ashleyjr/fft8051/hardware/fft8051/fft8051.kicad_pcb

## KiCad design hardware/fft8051/fft8051.kicad_pcb (2020-05-10)

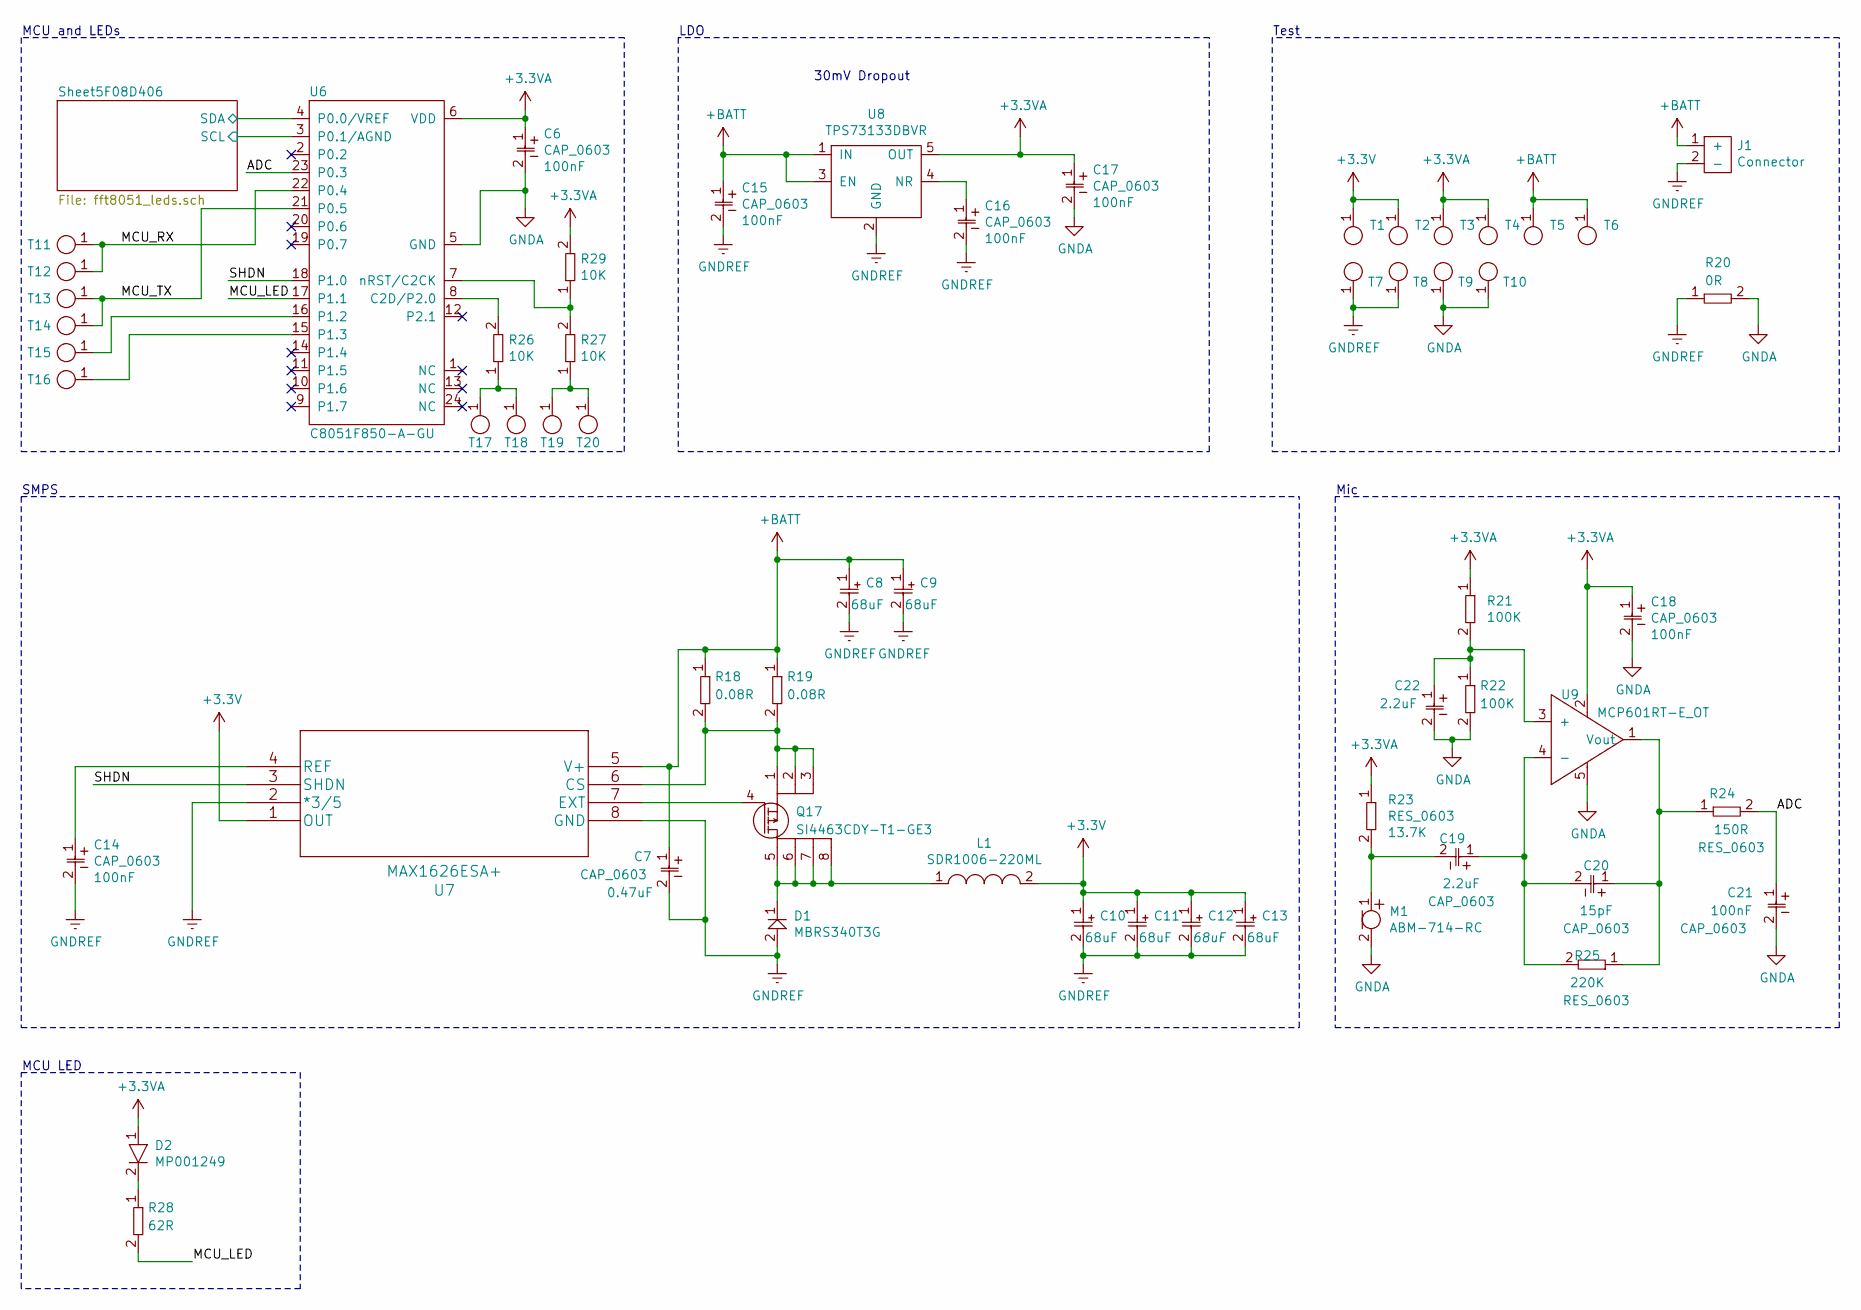
[picture p1: schematic fft8051.sch]

Parts:
C6, C7, C14, C15, C16, C17, C18, C19, C20, C21, C22: CAP_0603; 0603
C8, C9, C10, C11, C12, C13: T55B686M6R3C0070
D1: MBRS340T3G
D2: MP001249
J1: Connector
L1: SDR1006-220ML
M1: ABM-714-RC
Q17: SI4463CDY-T1-GE3
R18, R19, R20, R21, R22, R23, R24, R25, R26, R27, R28, R29: RES_0603; 0603
T1, T2, T3, T4, T5, T6, T7, T8, T9, T10, T11, T12, T13, T14, T15, T16, T17, T18, T19, T20: TestPoints; TestPoint
U6: C8051F850-A-GU
U7: MAX1626ESA+; MAX1626ESA&plus_
U8: TPS73133DBVR
U9: MCP601RT-E_OT; MCP601RT

Connections:
+3.3VA: C6.1, C17.1, C18.1, D2.1, R21.1, R23.1, R29.2, T3.1, T4.1, U6.6 (VDD), U8.5 (OUT), U9.2
+3V3: C10.1, C11.1, C12.1, C13.1, L1.2, T1.1, T2.1, U7.1 (OUT); also elsewhere on the board
+BATT: C7.1, C8.1, C9.1, C15.1, J1.1 (+), R18.1, R19.1, T5.1, T6.1, U7.5 (V+), U8.1 (IN), U8.3 (EN)
/ADC: C21.1, R24.2, U6.23 (P0.3)
/MCU_LED: R28.2, U6.17 (P1.1)
/MCU_RX: T11.1, T12.1, U6.22 (P0.4)
/MCU_TX: T13.1, T14.1, U6.21 (P0.5)
/SHDN: U6.18 (P1.0), U7.3 (SHDN)
/Sheet5F08D406/SCL: U6.3 (P0.1/AGND); also elsewhere on the board
/Sheet5F08D406/SDA: U6.4 (P0.0/VREF); also elsewhere on the board
GNDA: C6.2, C17.2, C18.2, C21.2, C22.2, M1.2, R20.2, R22.2, T9.1, T10.1, U6.5 (GND), U9.5
GNDREF: C7.2, C8.2, C9.2, C10.2, C11.2, C12.2, C13.2, C14.2, C15.2, C16.2, D1.2, J1.2 (-), R20.1, T7.1, T8.1, U7.2 (*3/5), U7.8 (GND), U8.2 (GND); also elsewhere on the board
unnamed: C14.1, U7.4 (REF)
unnamed: C16.1, U8.4 (NR)
unnamed: C19.1, C20.2, R25.2, U9.4 (-)
unnamed: C19.2, M1.1, R23.2
unnamed: C20.1, R24.1, R25.1, U9.1 (Vout)
unnamed: C22.1, R21.2, R22.1, U9.3 (+)
unnamed: D1.1, L1.1, Q17.5, Q17.6, Q17.7, Q17.8
unnamed: D2.2, R28.1
unnamed: Q17.1, Q17.2, Q17.3, R18.2, R19.2, U7.6 (CS)
unnamed: Q17.4, U7.7 (EXT)
unnamed: R26.1, T17.1, T18.1
unnamed: R26.2, U6.8 (C2D/P2.0)
unnamed: R27.1, T19.1, T20.1
unnamed: R27.2, R29.1, U6.7 (nRST/C2CK)
unnamed: T15.1, U6.16 (P1.2)
unnamed: T16.1, U6.15 (P1.3)

Notes on the sheet:
SMPS
MCU and LEDs
LDO
30mV Dropout
Test
Mic
MCU LED

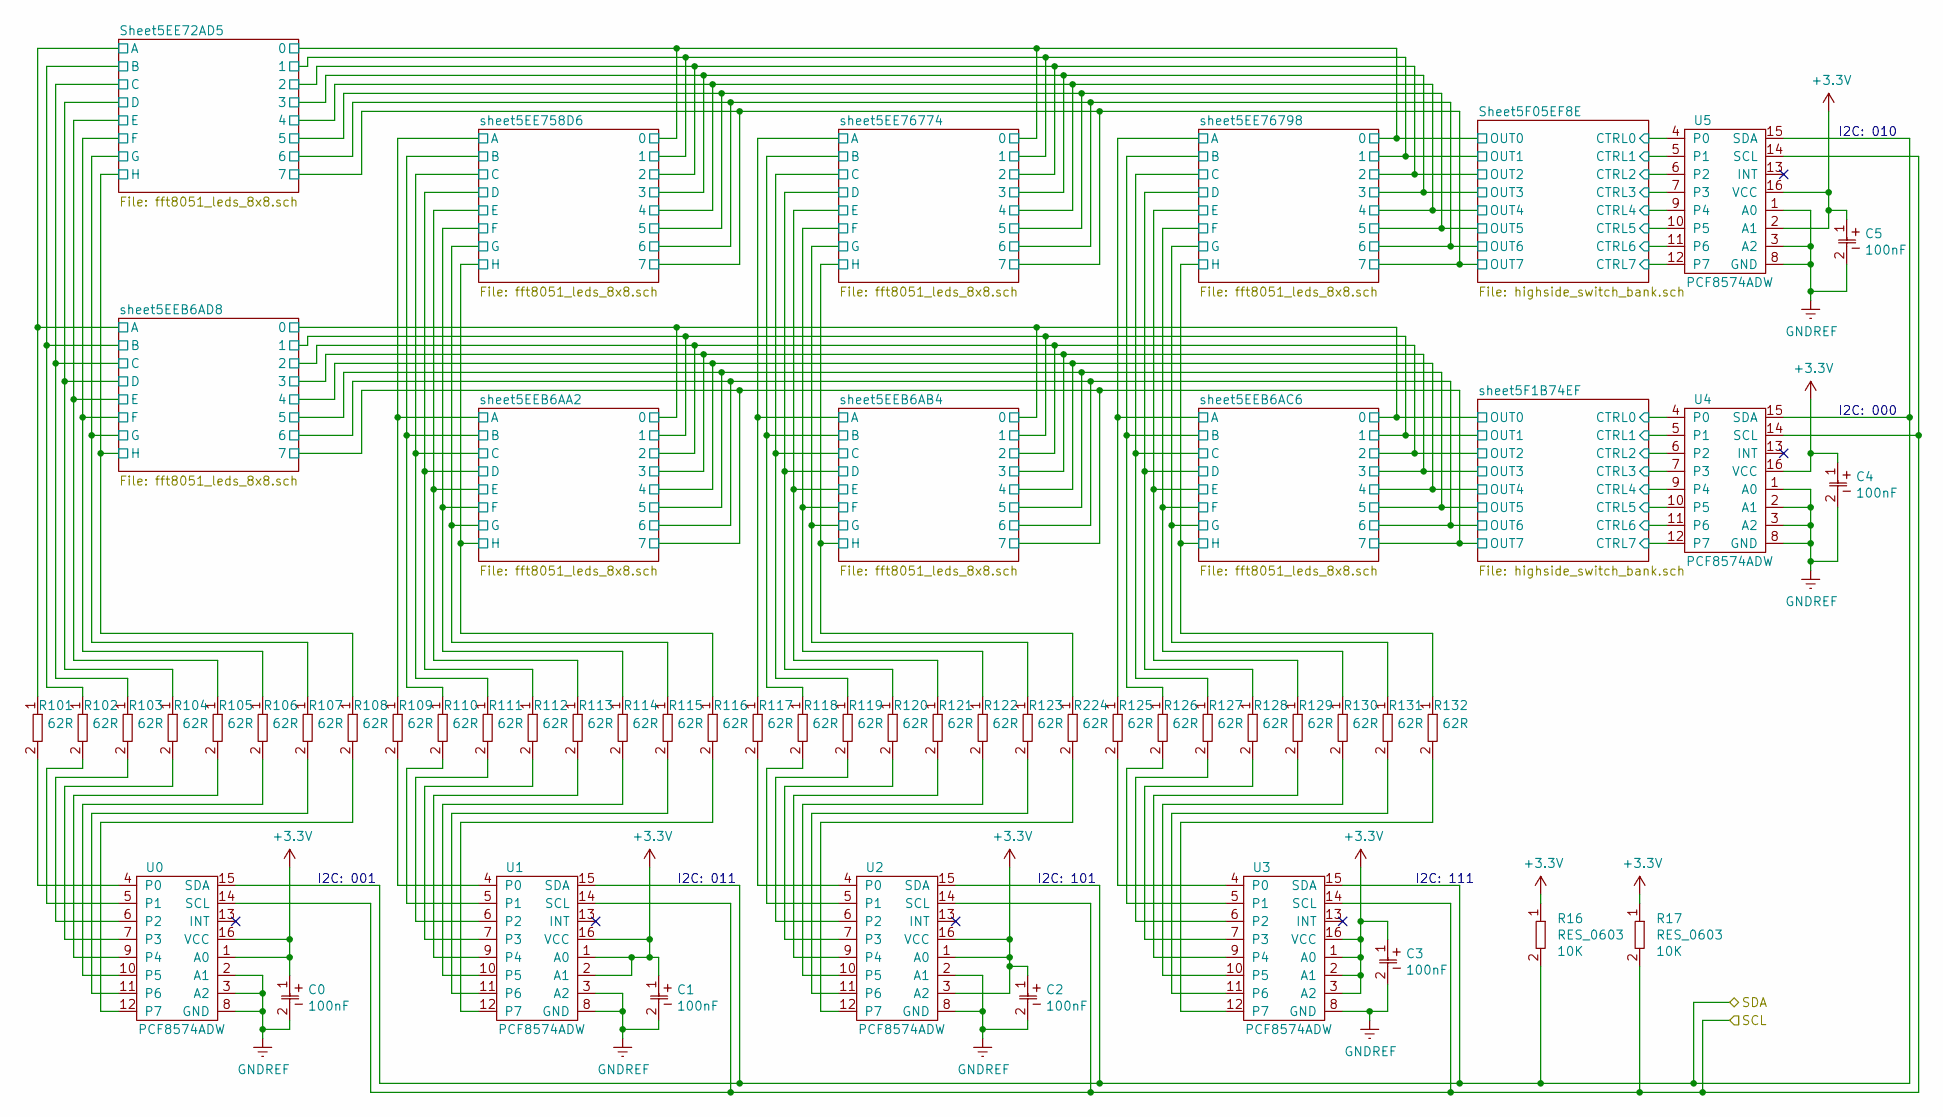
[picture p2: schematic fft8051_leds.sch]

Parts:
C0, C1, C2, C3, C4, C5: CAP_0603; 0603
R16, R17, R101, R102, R103, R104, R105, R106, R107, R108, R109, R110, R111, R112, R113, R114, R115, R116, R117, R118, R119, R120, R121, R122, R123, R125, R126, R127, R128, R129, R130, R131, R132, R224: RES_0603; 0603
U0, U1, U2, U3, U4, U5: PCF8574ADW

Connections:
+3V3: C0.1, C1.1, C2.1, C3.1, C4.1, C5.1, R16.1, R17.1, U0.1 (A0), U0.16 (VCC), U1.1 (A0), U1.2 (A1), U1.16 (VCC), U2.1 (A0), U2.3 (A2), U2.16 (VCC), U3.1 (A0), U3.2 (A1), U3.3 (A2), U3.16 (VCC), U4.16 (VCC), U5.2 (A1), U5.16 (VCC); also elsewhere on the board
/Sheet5F08D406/SCL: R17.2, U0.14 (SCL), U1.14 (SCL), U2.14 (SCL), U3.14 (SCL), U4.14 (SCL), U5.14 (SCL); also elsewhere on the board
/Sheet5F08D406/SDA: R16.2, U0.15 (SDA), U1.15 (SDA), U2.15 (SDA), U3.15 (SDA), U4.15 (SDA), U5.15 (SDA); also elsewhere on the board
/Sheet5F08D406/Sheet5EE72AD5/A: R101.1; also elsewhere on the board
/Sheet5F08D406/Sheet5EE72AD5/B: R102.1; also elsewhere on the board
/Sheet5F08D406/Sheet5EE72AD5/C: R103.1; also elsewhere on the board
/Sheet5F08D406/Sheet5EE72AD5/D: R104.1; also elsewhere on the board
/Sheet5F08D406/Sheet5EE72AD5/E: R105.1; also elsewhere on the board
/Sheet5F08D406/Sheet5EE72AD5/F: R106.1; also elsewhere on the board
/Sheet5F08D406/Sheet5EE72AD5/G: R107.1; also elsewhere on the board
/Sheet5F08D406/Sheet5EE72AD5/H: R108.1; also elsewhere on the board
/Sheet5F08D406/Sheet5F05EF8E/CTRL0: U5.4 (P0); also elsewhere on the board
/Sheet5F08D406/Sheet5F05EF8E/CTRL1: U5.5 (P1); also elsewhere on the board
/Sheet5F08D406/Sheet5F05EF8E/CTRL2: U5.6 (P2); also elsewhere on the board
/Sheet5F08D406/Sheet5F05EF8E/CTRL3: U5.7 (P3); also elsewhere on the board
/Sheet5F08D406/Sheet5F05EF8E/CTRL4: U5.9 (P4); also elsewhere on the board
/Sheet5F08D406/Sheet5F05EF8E/CTRL5: U5.10 (P5); also elsewhere on the board
/Sheet5F08D406/Sheet5F05EF8E/CTRL6: U5.11 (P6); also elsewhere on the board
/Sheet5F08D406/Sheet5F05EF8E/CTRL7: U5.12 (P7); also elsewhere on the board
/Sheet5F08D406/sheet5EE758D6/A: R109.1; also elsewhere on the board
/Sheet5F08D406/sheet5EE758D6/B: R110.1; also elsewhere on the board
/Sheet5F08D406/sheet5EE758D6/C: R111.1; also elsewhere on the board
/Sheet5F08D406/sheet5EE758D6/D: R112.1; also elsewhere on the board
/Sheet5F08D406/sheet5EE758D6/E: R113.1; also elsewhere on the board
/Sheet5F08D406/sheet5EE758D6/F: R114.1; also elsewhere on the board
/Sheet5F08D406/sheet5EE758D6/G: R115.1; also elsewhere on the board
/Sheet5F08D406/sheet5EE758D6/H: R116.1; also elsewhere on the board
/Sheet5F08D406/sheet5EE76774/A: R117.1; also elsewhere on the board
/Sheet5F08D406/sheet5EE76774/B: R118.1; also elsewhere on the board
/Sheet5F08D406/sheet5EE76774/C: R119.1; also elsewhere on the board
/Sheet5F08D406/sheet5EE76774/D: R120.1; also elsewhere on the board
/Sheet5F08D406/sheet5EE76774/E: R121.1; also elsewhere on the board
/Sheet5F08D406/sheet5EE76774/F: R122.1; also elsewhere on the board
/Sheet5F08D406/sheet5EE76774/G: R123.1; also elsewhere on the board
/Sheet5F08D406/sheet5EE76774/H: R224.1; also elsewhere on the board
/Sheet5F08D406/sheet5EE76798/A: R125.1; also elsewhere on the board
/Sheet5F08D406/sheet5EE76798/B: R126.1; also elsewhere on the board
/Sheet5F08D406/sheet5EE76798/C: R127.1; also elsewhere on the board
/Sheet5F08D406/sheet5EE76798/D: R128.1; also elsewhere on the board
/Sheet5F08D406/sheet5EE76798/E: R129.1; also elsewhere on the board
/Sheet5F08D406/sheet5EE76798/F: R130.1; also elsewhere on the board
/Sheet5F08D406/sheet5EE76798/G: R131.1; also elsewhere on the board
/Sheet5F08D406/sheet5EE76798/H: R132.1; also elsewhere on the board
/Sheet5F08D406/sheet5F1B74EF/CTRL0: U4.4 (P0); also elsewhere on the board
/Sheet5F08D406/sheet5F1B74EF/CTRL1: U4.5 (P1); also elsewhere on the board
/Sheet5F08D406/sheet5F1B74EF/CTRL2: U4.6 (P2); also elsewhere on the board
/Sheet5F08D406/sheet5F1B74EF/CTRL3: U4.7 (P3); also elsewhere on the board
/Sheet5F08D406/sheet5F1B74EF/CTRL4: U4.9 (P4); also elsewhere on the board
/Sheet5F08D406/sheet5F1B74EF/CTRL5: U4.10 (P5); also elsewhere on the board
/Sheet5F08D406/sheet5F1B74EF/CTRL6: U4.11 (P6); also elsewhere on the board
/Sheet5F08D406/sheet5F1B74EF/CTRL7: U4.12 (P7); also elsewhere on the board
GNDREF: C0.2, C1.2, C2.2, C3.2, C4.2, C5.2, U0.2 (A1), U0.3 (A2), U0.8 (GND), U1.3 (A2), U1.8 (GND), U2.2 (A1), U2.8 (GND), U3.8 (GND), U4.1 (A0), U4.2 (A1), U4.3 (A2), U4.8 (GND), U5.1 (A0), U5.3 (A2), U5.8 (GND); also elsewhere on the board
unnamed: R101.2, U0.4 (P0)
unnamed: R102.2, U0.5 (P1)
unnamed: R103.2, U0.6 (P2)
unnamed: R104.2, U0.7 (P3)
unnamed: R105.2, U0.9 (P4)
unnamed: R106.2, U0.10 (P5)
unnamed: R107.2, U0.11 (P6)
unnamed: R108.2, U0.12 (P7)
unnamed: R109.2, U1.4 (P0)
unnamed: R110.2, U1.5 (P1)
unnamed: R111.2, U1.6 (P2)
unnamed: R112.2, U1.7 (P3)
unnamed: R113.2, U1.9 (P4)
unnamed: R114.2, U1.10 (P5)
unnamed: R115.2, U1.11 (P6)
unnamed: R116.2, U1.12 (P7)
unnamed: R117.2, U2.4 (P0)
unnamed: R118.2, U2.5 (P1)
unnamed: R119.2, U2.6 (P2)
unnamed: R120.2, U2.7 (P3)
unnamed: R121.2, U2.9 (P4)
unnamed: R122.2, U2.10 (P5)
unnamed: R123.2, U2.11 (P6)
unnamed: R125.2, U3.4 (P0)
unnamed: R126.2, U3.5 (P1)
unnamed: R127.2, U3.6 (P2)
unnamed: R128.2, U3.7 (P3)
unnamed: R129.2, U3.9 (P4)
unnamed: R130.2, U3.10 (P5)
unnamed: R131.2, U3.11 (P6)
unnamed: R132.2, U3.12 (P7)
unnamed: R224.2, U2.12 (P7)

Notes on the sheet:
I2C: 111
I2C: 101
I2C: 011
I2C: 001
I2C: 000
I2C: 010

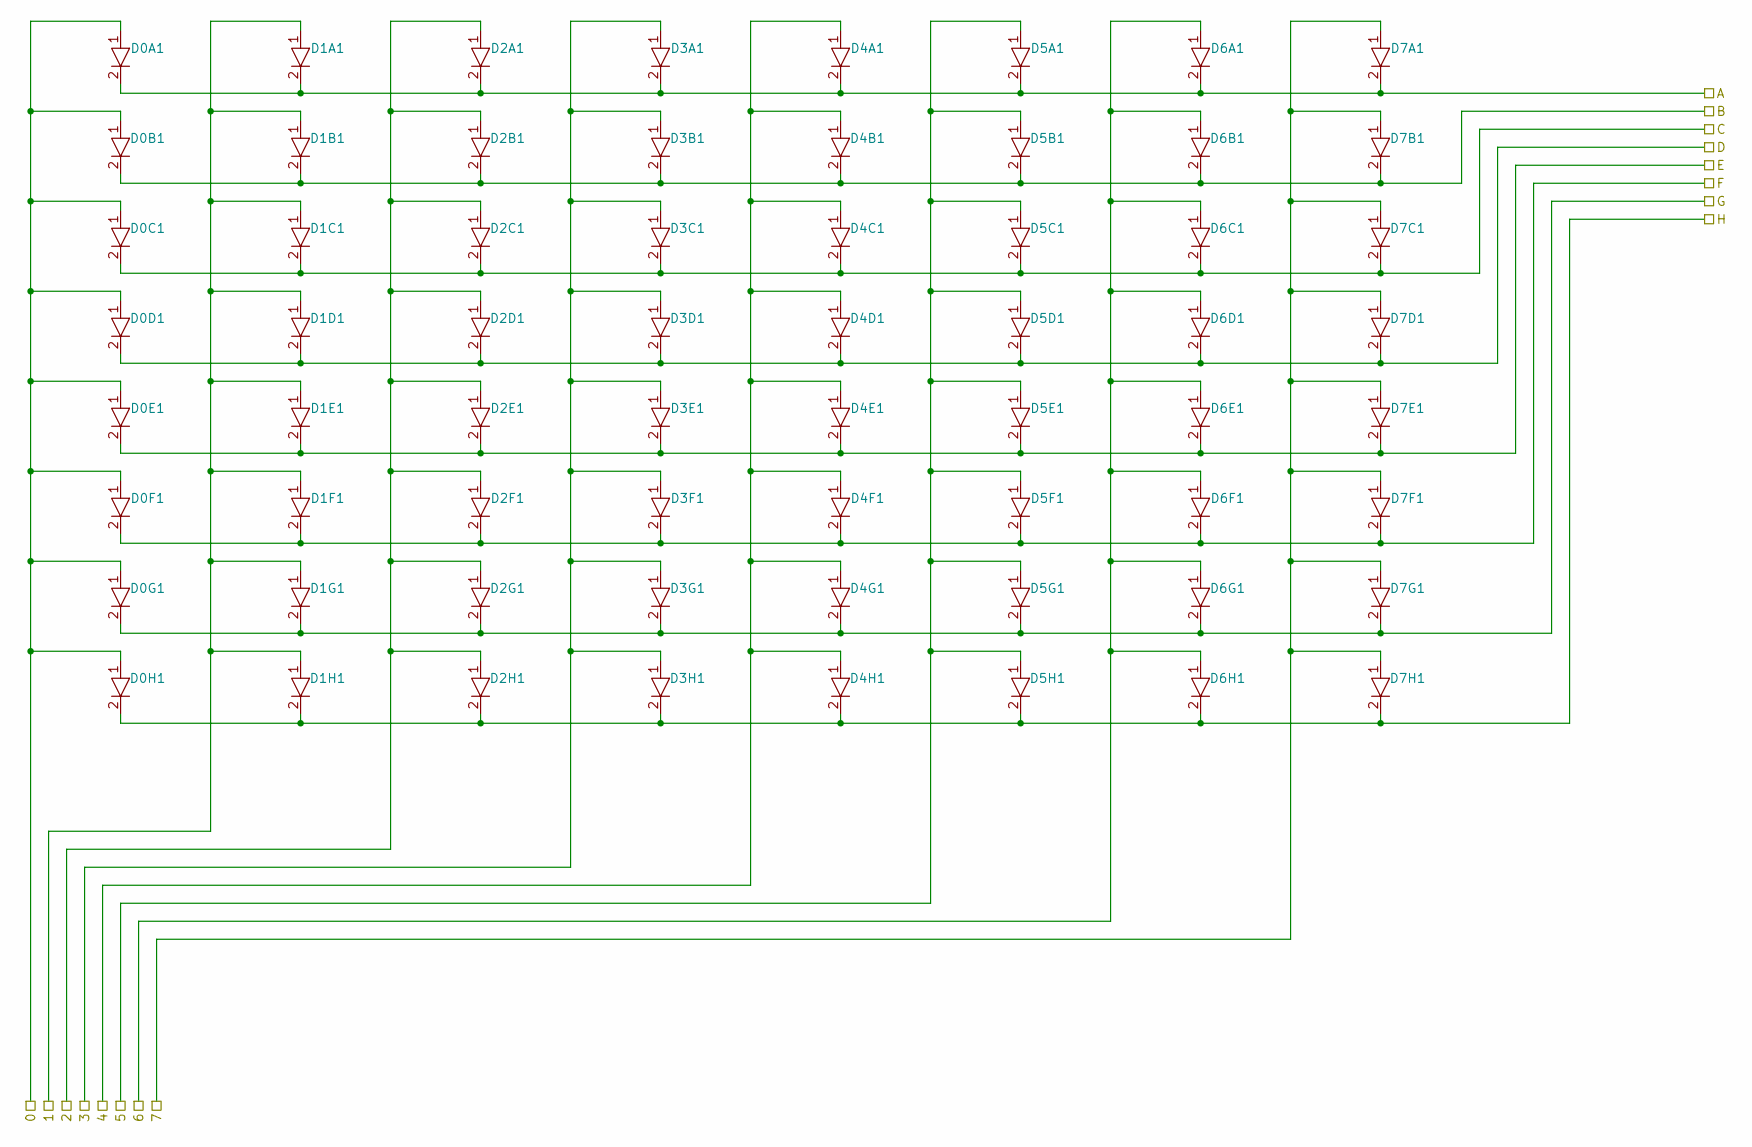
[picture p3: schematic fft8051_leds_8x8.sch]

Parts:
D0A1, D0B1, D0C1, D0D1, D0E1, D0F1, D0G1, D0H1, D1A1, D1B1, D1C1, D1D1, D1E1, D1F1, D1G1, D1H1, D2A1, D2B1, D2C1, D2D1, D2E1, D2F1, D2G1, D2H1, D3A1, D3B1, D3C1, D3D1, D3E1, D3F1, D3G1, D3H1, D4A1, D4B1, D4C1, D4D1, D4E1, D4F1, D4G1, D4H1, D5A1, D5B1, D5C1, D5D1, D5E1, D5F1, D5G1, D5H1, D6A1, D6B1, D6C1, D6D1, D6E1, D6F1, D6G1, D6H1, D7A1, D7B1, D7C1, D7D1, D7E1, D7F1, D7G1, D7H1: MP001249

Connections:
/Sheet5F08D406/Sheet5EE72AD5/0: D0A1.1, D0B1.1, D0C1.1, D0D1.1, D0E1.1, D0F1.1, D0G1.1, D0H1.1; also elsewhere on the board
/Sheet5F08D406/Sheet5EE72AD5/1: D1A1.1, D1B1.1, D1C1.1, D1D1.1, D1E1.1, D1F1.1, D1G1.1, D1H1.1; also elsewhere on the board
/Sheet5F08D406/Sheet5EE72AD5/2: D2A1.1, D2B1.1, D2C1.1, D2D1.1, D2E1.1, D2F1.1, D2G1.1, D2H1.1; also elsewhere on the board
/Sheet5F08D406/Sheet5EE72AD5/3: D3A1.1, D3B1.1, D3C1.1, D3D1.1, D3E1.1, D3F1.1, D3G1.1, D3H1.1; also elsewhere on the board
/Sheet5F08D406/Sheet5EE72AD5/4: D4A1.1, D4B1.1, D4C1.1, D4D1.1, D4E1.1, D4F1.1, D4G1.1, D4H1.1; also elsewhere on the board
/Sheet5F08D406/Sheet5EE72AD5/5: D5A1.1, D5B1.1, D5C1.1, D5D1.1, D5E1.1, D5F1.1, D5G1.1, D5H1.1; also elsewhere on the board
/Sheet5F08D406/Sheet5EE72AD5/6: D6A1.1, D6B1.1, D6C1.1, D6D1.1, D6E1.1, D6F1.1, D6G1.1, D6H1.1; also elsewhere on the board
/Sheet5F08D406/Sheet5EE72AD5/7: D7A1.1, D7B1.1, D7C1.1, D7D1.1, D7E1.1, D7F1.1, D7G1.1, D7H1.1; also elsewhere on the board
/Sheet5F08D406/sheet5EE758D6/A: D0A1.2, D1A1.2, D2A1.2, D3A1.2, D4A1.2, D5A1.2, D6A1.2, D7A1.2; also elsewhere on the board
/Sheet5F08D406/sheet5EE758D6/B: D0B1.2, D1B1.2, D2B1.2, D3B1.2, D4B1.2, D5B1.2, D6B1.2, D7B1.2; also elsewhere on the board
/Sheet5F08D406/sheet5EE758D6/C: D0C1.2, D1C1.2, D2C1.2, D3C1.2, D4C1.2, D5C1.2, D6C1.2, D7C1.2; also elsewhere on the board
/Sheet5F08D406/sheet5EE758D6/D: D0D1.2, D1D1.2, D2D1.2, D3D1.2, D4D1.2, D5D1.2, D6D1.2, D7D1.2; also elsewhere on the board
/Sheet5F08D406/sheet5EE758D6/E: D0E1.2, D1E1.2, D2E1.2, D3E1.2, D4E1.2, D5E1.2, D6E1.2, D7E1.2; also elsewhere on the board
/Sheet5F08D406/sheet5EE758D6/F: D0F1.2, D1F1.2, D2F1.2, D3F1.2, D4F1.2, D5F1.2, D6F1.2, D7F1.2; also elsewhere on the board
/Sheet5F08D406/sheet5EE758D6/G: D0G1.2, D1G1.2, D2G1.2, D3G1.2, D4G1.2, D5G1.2, D6G1.2, D7G1.2; also elsewhere on the board
/Sheet5F08D406/sheet5EE758D6/H: D0H1.2, D1H1.2, D2H1.2, D3H1.2, D4H1.2, D5H1.2, D6H1.2, D7H1.2; also elsewhere on the board

Parts of its further copies:
D0A2, D0A3, D0A4, D0A5, D0A6, D0A7, D0A8, D0B2, D0B3, D0B4, D0B5, D0B6, D0B7, D0B8, D0C2, D0C3, D0C4, D0C5, D0C6, D0C7, D0C8, D0D2, D0D3, D0D4, D0D5, D0D6, D0D7, D0D8, D0E2, D0E3, D0E4, D0E5, D0E6, D0E7, D0E8, D0F2, D0F3, D0F4, D0F5, D0F6, D0F7, D0F8, D0G2, D0G3, D0G4, D0G5, D0G6, D0G7, D0G8, D0H2, D0H3, D0H4, D0H5, D0H6, D0H7, D0H8, D1A2, D1A3, D1A4, D1A5, D1A6, D1A7, D1A8, D1B2, D1B3, D1B4, D1B5, D1B6, D1B7, D1B8, D1C2, D1C3, D1C4, D1C5, D1C6, D1C7, D1C8, D1D2, D1D3, D1D4, D1D5, D1D6, D1D7, D1D8, D1E2, D1E3, D1E4, D1E5, D1E6, D1E7, D1E8, D1F2, D1F3, D1F4, D1F5, D1F6, D1F7, D1F8, D1G2, D1G3, D1G4, D1G5, D1G6, D1G7, D1G8, D1H2, D1H3, D1H4, D1H5, D1H6, D1H7, D1H8, D2A2, D2A3, D2A4, D2A5, D2A6, D2A7, D2A8, D2B2, D2B3, D2B4, D2B5, D2B6, D2B7, D2B8, D2C2, D2C3, D2C4, D2C5, D2C6, D2C7, D2C8, D2D2, D2D3, D2D4, D2D5, D2D6, D2D7, D2D8, D2E2, D2E3, D2E4, D2E5, D2E6, D2E7, D2E8, D2F2, D2F3, D2F4, D2F5, D2F6, D2F7, D2F8, D2G2, D2G3, D2G4, D2G5, D2G6, D2G7, D2G8, D2H2, D2H3, D2H4, D2H5, D2H6, D2H7, D2H8, D3A2, D3A3, D3A4, D3A5, D3A6, D3A7, D3A8, D3B2, D3B3, D3B4, D3B5, D3B6, D3B7, D3B8, D3C2, D3C3, D3C4, D3C5, D3C6, D3C7, D3C8, D3D2, D3D3, D3D4, D3D5, D3D6, D3D7, D3D8, D3E2, D3E3, D3E4, D3E5, D3E6, D3E7, D3E8, D3F2, D3F3, D3F4, D3F5, D3F6, D3F7, D3F8, D3G2, D3G3, D3G4, D3G5, D3G6, D3G7, D3G8, D3H2, D3H3, D3H4, D3H5, D3H6, D3H7, D3H8, D4A2, D4A3, D4A4, D4A5, D4A6, D4A7, D4A8, D4B2, D4B3, D4B4, D4B5, D4B6, D4B7, D4B8, D4C2, D4C3, D4C4, D4C5, D4C6, D4C7, D4C8, D4D2, D4D3, D4D4, D4D5, D4D6, D4D7, D4D8, D4E2, D4E3, D4E4, D4E5, D4E6, D4E7, D4E8, D4F2, D4F3, D4F4, D4F5, D4F6, D4F7, D4F8, D4G2, D4G3, D4G4, D4G5, D4G6, D4G7, D4G8, D4H2, D4H3, D4H4, D4H5, D4H6, D4H7, D4H8, D5A2, D5A3, D5A4, D5A5, D5A6, D5A7, D5A8, D5B2, D5B3, D5B4, D5B5, D5B6, D5B7, D5B8, D5C2, D5C3, D5C4, D5C5, D5C6, D5C7, D5C8, D5D2, D5D3, D5D4, D5D5, D5D6, D5D7, D5D8, D5E2, D5E3, D5E4, D5E5, D5E6, D5E7, D5E8, D5F2, D5F3, D5F4, D5F5, D5F6, D5F7, D5F8, D5G2, D5G3, D5G4, D5G5, D5G6, D5G7, D5G8, D5H2, D5H3, D5H4, D5H5, D5H6, D5H7, D5H8, D6A2, D6A3, D6A4, D6A5, D6A6, D6A7, D6A8, D6B2, D6B3, D6B4, D6B5, D6B6, D6B7, D6B8, D6C2, D6C3, D6C4, D6C5, D6C6, D6C7, D6C8, D6D2, D6D3, D6D4, D6D5, D6D6, D6D7, D6D8, D6E2, D6E3, D6E4, D6E5, D6E6, D6E7, D6E8, D6F2, D6F3, D6F4, D6F5, D6F6, D6F7, D6F8, D6G2, D6G3, D6G4, D6G5, D6G6, D6G7, D6G8, D6H2, D6H3, D6H4, D6H5, D6H6, D6H7, D6H8, D7A2, D7A3, D7A4, D7A5, D7A6, D7A7, D7A8, D7B2, D7B3, D7B4, D7B5, D7B6, D7B7, D7B8, D7C2, D7C3, D7C4, D7C5, D7C6, D7C7, D7C8, D7D2, D7D3, D7D4, D7D5, D7D6, D7D7, D7D8, D7E2, D7E3, D7E4, D7E5, D7E6, D7E7, D7E8, D7F2, D7F3, D7F4, D7F5, D7F6, D7F7, D7F8, D7G2, D7G3, D7G4, D7G5, D7G6, D7G7, D7G8, D7H2, D7H3, D7H4, D7H5, D7H6, D7H7, D7H8: MP001249

Connections of its further copies:
/Sheet5F08D406/Sheet5EE72AD5/0: D0A2.1, D0A3.1, D0A4.1, D0B2.1, D0B3.1, D0B4.1, D0C2.1, D0C3.1, D0C4.1, D0D2.1, D0D3.1, D0D4.1, D0E2.1, D0E3.1, D0E4.1, D0F2.1, D0F3.1, D0F4.1, D0G2.1, D0G3.1, D0G4.1, D0H2.1, D0H3.1, D0H4.1; also elsewhere on the board
/Sheet5F08D406/Sheet5EE72AD5/1: D1A2.1, D1A3.1, D1A4.1, D1B2.1, D1B3.1, D1B4.1, D1C2.1, D1C3.1, D1C4.1, D1D2.1, D1D3.1, D1D4.1, D1E2.1, D1E3.1, D1E4.1, D1F2.1, D1F3.1, D1F4.1, D1G2.1, D1G3.1, D1G4.1, D1H2.1, D1H3.1, D1H4.1; also elsewhere on the board
/Sheet5F08D406/Sheet5EE72AD5/2: D2A2.1, D2A3.1, D2A4.1, D2B2.1, D2B3.1, D2B4.1, D2C2.1, D2C3.1, D2C4.1, D2D2.1, D2D3.1, D2D4.1, D2E2.1, D2E3.1, D2E4.1, D2F2.1, D2F3.1, D2F4.1, D2G2.1, D2G3.1, D2G4.1, D2H2.1, D2H3.1, D2H4.1; also elsewhere on the board
/Sheet5F08D406/Sheet5EE72AD5/3: D3A2.1, D3A3.1, D3A4.1, D3B2.1, D3B3.1, D3B4.1, D3C2.1, D3C3.1, D3C4.1, D3D2.1, D3D3.1, D3D4.1, D3E2.1, D3E3.1, D3E4.1, D3F2.1, D3F3.1, D3F4.1, D3G2.1, D3G3.1, D3G4.1, D3H2.1, D3H3.1, D3H4.1; also elsewhere on the board
/Sheet5F08D406/Sheet5EE72AD5/4: D4A2.1, D4A3.1, D4A4.1, D4B2.1, D4B3.1, D4B4.1, D4C2.1, D4C3.1, D4C4.1, D4D2.1, D4D3.1, D4D4.1, D4E2.1, D4E3.1, D4E4.1, D4F2.1, D4F3.1, D4F4.1, D4G2.1, D4G3.1, D4G4.1, D4H2.1, D4H3.1, D4H4.1; also elsewhere on the board
/Sheet5F08D406/Sheet5EE72AD5/5: D5A2.1, D5A3.1, D5A4.1, D5B2.1, D5B3.1, D5B4.1, D5C2.1, D5C3.1, D5C4.1, D5D2.1, D5D3.1, D5D4.1, D5E2.1, D5E3.1, D5E4.1, D5F2.1, D5F3.1, D5F4.1, D5G2.1, D5G3.1, D5G4.1, D5H2.1, D5H3.1, D5H4.1; also elsewhere on the board
/Sheet5F08D406/Sheet5EE72AD5/6: D6A2.1, D6A3.1, D6A4.1, D6B2.1, D6B3.1, D6B4.1, D6C2.1, D6C3.1, D6C4.1, D6D2.1, D6D3.1, D6D4.1, D6E2.1, D6E3.1, D6E4.1, D6F2.1, D6F3.1, D6F4.1, D6G2.1, D6G3.1, D6G4.1, D6H2.1, D6H3.1, D6H4.1; also elsewhere on the board
/Sheet5F08D406/Sheet5EE72AD5/7: D7A2.1, D7A3.1, D7A4.1, D7B2.1, D7B3.1, D7B4.1, D7C2.1, D7C3.1, D7C4.1, D7D2.1, D7D3.1, D7D4.1, D7E2.1, D7E3.1, D7E4.1, D7F2.1, D7F3.1, D7F4.1, D7G2.1, D7G3.1, D7G4.1, D7H2.1, D7H3.1, D7H4.1; also elsewhere on the board
/Sheet5F08D406/Sheet5EE72AD5/A: D0A4.2, D0A8.2, D1A4.2, D1A8.2, D2A4.2, D2A8.2, D3A4.2, D3A8.2, D4A4.2, D4A8.2, D5A4.2, D5A8.2, D6A4.2, D6A8.2, D7A4.2, D7A8.2; also elsewhere on the board
/Sheet5F08D406/Sheet5EE72AD5/B: D0B4.2, D0B8.2, D1B4.2, D1B8.2, D2B4.2, D2B8.2, D3B4.2, D3B8.2, D4B4.2, D4B8.2, D5B4.2, D5B8.2, D6B4.2, D6B8.2, D7B4.2, D7B8.2; also elsewhere on the board
/Sheet5F08D406/Sheet5EE72AD5/C: D0C4.2, D0C8.2, D1C4.2, D1C8.2, D2C4.2, D2C8.2, D3C4.2, D3C8.2, D4C4.2, D4C8.2, D5C4.2, D5C8.2, D6C4.2, D6C8.2, D7C4.2, D7C8.2; also elsewhere on the board
/Sheet5F08D406/Sheet5EE72AD5/D: D0D4.2, D0D8.2, D1D4.2, D1D8.2, D2D4.2, D2D8.2, D3D4.2, D3D8.2, D4D4.2, D4D8.2, D5D4.2, D5D8.2, D6D4.2, D6D8.2, D7D4.2, D7D8.2; also elsewhere on the board
/Sheet5F08D406/Sheet5EE72AD5/E: D0E4.2, D0E8.2, D1E4.2, D1E8.2, D2E4.2, D2E8.2, D3E4.2, D3E8.2, D4E4.2, D4E8.2, D5E4.2, D5E8.2, D6E4.2, D6E8.2, D7E4.2, D7E8.2; also elsewhere on the board
/Sheet5F08D406/Sheet5EE72AD5/F: D0F4.2, D0F8.2, D1F4.2, D1F8.2, D2F4.2, D2F8.2, D3F4.2, D3F8.2, D4F4.2, D4F8.2, D5F4.2, D5F8.2, D6F4.2, D6F8.2, D7F4.2, D7F8.2; also elsewhere on the board
/Sheet5F08D406/Sheet5EE72AD5/G: D0G4.2, D0G8.2, D1G4.2, D1G8.2, D2G4.2, D2G8.2, D3G4.2, D3G8.2, D4G4.2, D4G8.2, D5G4.2, D5G8.2, D6G4.2, D6G8.2, D7G4.2, D7G8.2; also elsewhere on the board
/Sheet5F08D406/Sheet5EE72AD5/H: D0H4.2, D0H8.2, D1H4.2, D1H8.2, D2H4.2, D2H8.2, D3H4.2, D3H8.2, D4H4.2, D4H8.2, D5H4.2, D5H8.2, D6H4.2, D6H8.2, D7H4.2, D7H8.2; also elsewhere on the board
/Sheet5F08D406/sheet5EE758D6/A: D0A5.2, D1A5.2, D2A5.2, D3A5.2, D4A5.2, D5A5.2, D6A5.2, D7A5.2; also elsewhere on the board
/Sheet5F08D406/sheet5EE758D6/B: D0B5.2, D1B5.2, D2B5.2, D3B5.2, D4B5.2, D5B5.2, D6B5.2, D7B5.2; also elsewhere on the board
/Sheet5F08D406/sheet5EE758D6/C: D0C5.2, D1C5.2, D2C5.2, D3C5.2, D4C5.2, D5C5.2, D6C5.2, D7C5.2; also elsewhere on the board
/Sheet5F08D406/sheet5EE758D6/D: D0D5.2, D1D5.2, D2D5.2, D3D5.2, D4D5.2, D5D5.2, D6D5.2, D7D5.2; also elsewhere on the board
/Sheet5F08D406/sheet5EE758D6/E: D0E5.2, D1E5.2, D2E5.2, D3E5.2, D4E5.2, D5E5.2, D6E5.2, D7E5.2; also elsewhere on the board
/Sheet5F08D406/sheet5EE758D6/F: D0F5.2, D1F5.2, D2F5.2, D3F5.2, D4F5.2, D5F5.2, D6F5.2, D7F5.2; also elsewhere on the board
/Sheet5F08D406/sheet5EE758D6/G: D0G5.2, D1G5.2, D2G5.2, D3G5.2, D4G5.2, D5G5.2, D6G5.2, D7G5.2; also elsewhere on the board
/Sheet5F08D406/sheet5EE758D6/H: D0H5.2, D1H5.2, D2H5.2, D3H5.2, D4H5.2, D5H5.2, D6H5.2, D7H5.2; also elsewhere on the board
/Sheet5F08D406/sheet5EE76774/A: D0A2.2, D0A6.2, D1A2.2, D1A6.2, D2A2.2, D2A6.2, D3A2.2, D3A6.2, D4A2.2, D4A6.2, D5A2.2, D5A6.2, D6A2.2, D6A6.2, D7A2.2, D7A6.2; also elsewhere on the board
/Sheet5F08D406/sheet5EE76774/B: D0B2.2, D0B6.2, D1B2.2, D1B6.2, D2B2.2, D2B6.2, D3B2.2, D3B6.2, D4B2.2, D4B6.2, D5B2.2, D5B6.2, D6B2.2, D6B6.2, D7B2.2, D7B6.2; also elsewhere on the board
/Sheet5F08D406/sheet5EE76774/C: D0C2.2, D0C6.2, D1C2.2, D1C6.2, D2C2.2, D2C6.2, D3C2.2, D3C6.2, D4C2.2, D4C6.2, D5C2.2, D5C6.2, D6C2.2, D6C6.2, D7C2.2, D7C6.2; also elsewhere on the board
/Sheet5F08D406/sheet5EE76774/D: D0D2.2, D0D6.2, D1D2.2, D1D6.2, D2D2.2, D2D6.2, D3D2.2, D3D6.2, D4D2.2, D4D6.2, D5D2.2, D5D6.2, D6D2.2, D6D6.2, D7D2.2, D7D6.2; also elsewhere on the board
/Sheet5F08D406/sheet5EE76774/E: D0E2.2, D0E6.2, D1E2.2, D1E6.2, D2E2.2, D2E6.2, D3E2.2, D3E6.2, D4E2.2, D4E6.2, D5E2.2, D5E6.2, D6E2.2, D6E6.2, D7E2.2, D7E6.2; also elsewhere on the board
/Sheet5F08D406/sheet5EE76774/F: D0F2.2, D0F6.2, D1F2.2, D1F6.2, D2F2.2, D2F6.2, D3F2.2, D3F6.2, D4F2.2, D4F6.2, D5F2.2, D5F6.2, D6F2.2, D6F6.2, D7F2.2, D7F6.2; also elsewhere on the board
/Sheet5F08D406/sheet5EE76774/G: D0G2.2, D0G6.2, D1G2.2, D1G6.2, D2G2.2, D2G6.2, D3G2.2, D3G6.2, D4G2.2, D4G6.2, D5G2.2, D5G6.2, D6G2.2, D6G6.2, D7G2.2, D7G6.2; also elsewhere on the board
/Sheet5F08D406/sheet5EE76774/H: D0H2.2, D0H6.2, D1H2.2, D1H6.2, D2H2.2, D2H6.2, D3H2.2, D3H6.2, D4H2.2, D4H6.2, D5H2.2, D5H6.2, D6H2.2, D6H6.2, D7H2.2, D7H6.2; also elsewhere on the board
/Sheet5F08D406/sheet5EE76798/A: D0A3.2, D0A7.2, D1A3.2, D1A7.2, D2A3.2, D2A7.2, D3A3.2, D3A7.2, D4A3.2, D4A7.2, D5A3.2, D6A3.2, D6A7.2, D7A3.2, D7A7.2; also elsewhere on the board
/Sheet5F08D406/sheet5EE76798/B: D0B3.2, D0B7.2, D1B3.2, D1B7.2, D2B3.2, D2B7.2, D3B3.2, D3B7.2, D4B3.2, D4B7.2, D5B3.2, D5B7.2, D6B3.2, D6B7.2, D7B3.2, D7B7.2; also elsewhere on the board
/Sheet5F08D406/sheet5EE76798/C: D0C3.2, D0C7.2, D1C3.2, D1C7.2, D2C3.2, D2C7.2, D3C3.2, D3C7.2, D4C3.2, D4C7.2, D5C3.2, D5C7.2, D6C3.2, D6C7.2, D7C3.2, D7C7.2; also elsewhere on the board
/Sheet5F08D406/sheet5EE76798/D: D0D3.2, D0D7.2, D1D3.2, D1D7.2, D2D3.2, D2D7.2, D3D3.2, D3D7.2, D4D3.2, D4D7.2, D5D3.2, D5D7.2, D6D3.2, D6D7.2, D7D3.2, D7D7.2; also elsewhere on the board
/Sheet5F08D406/sheet5EE76798/E: D0E3.2, D0E7.2, D1E3.2, D1E7.2, D2E3.2, D2E7.2, D3E3.2, D3E7.2, D4E3.2, D4E7.2, D5E3.2, D5E7.2, D6E3.2, D6E7.2, D7E3.2, D7E7.2; also elsewhere on the board
/Sheet5F08D406/sheet5EE76798/F: D0F3.2, D0F7.2, D1F3.2, D1F7.2, D2F3.2, D2F7.2, D3F3.2, D3F7.2, D4F3.2, D4F7.2, D5F3.2, D5F7.2, D6F3.2, D6F7.2, D7F3.2, D7F7.2; also elsewhere on the board
/Sheet5F08D406/sheet5EE76798/G: D0G3.2, D0G7.2, D1G3.2, D1G7.2, D2G3.2, D2G7.2, D3G3.2, D3G7.2, D4G3.2, D4G7.2, D5G3.2, D5G7.2, D6G3.2, D6G7.2, D7G3.2, D7G7.2; also elsewhere on the board
/Sheet5F08D406/sheet5EE76798/H: D0H3.2, D0H7.2, D1H3.2, D1H7.2, D2H3.2, D2H7.2, D3H3.2, D3H7.2, D4H3.2, D4H7.2, D5H3.2, D5H7.2, D6H3.2, D6H7.2, D7H3.2, D7H7.2; also elsewhere on the board
/Sheet5F08D406/sheet5EEB6AA2/0: D0A5.1, D0A6.1, D0A7.1, D0A8.1, D0B5.1, D0B6.1, D0B7.1, D0B8.1, D0C5.1, D0C6.1, D0C7.1, D0C8.1, D0D5.1, D0D6.1, D0D7.1, D0D8.1, D0E5.1, D0E6.1, D0E7.1, D0E8.1, D0F5.1, D0F6.1, D0F7.1, D0F8.1, D0G5.1, D0G6.1, D0G7.1, D0G8.1, D0H5.1, D0H6.1, D0H7.1, D0H8.1; also elsewhere on the board
/Sheet5F08D406/sheet5EEB6AA2/1: D1A5.1, D1A6.1, D1A7.1, D1A8.1, D1B5.1, D1B6.1, D1B7.1, D1B8.1, D1C5.1, D1C6.1, D1C7.1, D1C8.1, D1D5.1, D1D6.1, D1D7.1, D1D8.1, D1E5.1, D1E6.1, D1E7.1, D1E8.1, D1F5.1, D1F6.1, D1F7.1, D1F8.1, D1G5.1, D1G6.1, D1G7.1, D1G8.1, D1H5.1, D1H6.1, D1H7.1, D1H8.1; also elsewhere on the board
/Sheet5F08D406/sheet5EEB6AA2/2: D2A5.1, D2A6.1, D2A7.1, D2A8.1, D2B5.1, D2B6.1, D2B7.1, D2B8.1, D2C5.1, D2C6.1, D2C7.1, D2C8.1, D2D5.1, D2D6.1, D2D7.1, D2D8.1, D2E5.1, D2E6.1, D2E7.1, D2E8.1, D2F5.1, D2F6.1, D2F7.1, D2F8.1, D2G5.1, D2G6.1, D2G7.1, D2G8.1, D2H5.1, D2H6.1, D2H7.1, D2H8.1; also elsewhere on the board
/Sheet5F08D406/sheet5EEB6AA2/3: D3A5.1, D3A6.1, D3A7.1, D3A8.1, D3B5.1, D3B6.1, D3B7.1, D3B8.1, D3C5.1, D3C6.1, D3C7.1, D3C8.1, D3D5.1, D3D6.1, D3D7.1, D3D8.1, D3E5.1, D3E6.1, D3E7.1, D3E8.1, D3F5.1, D3F6.1, D3F7.1, D3F8.1, D3G5.1, D3G6.1, D3G7.1, D3G8.1, D3H5.1, D3H6.1, D3H7.1, D3H8.1; also elsewhere on the board
/Sheet5F08D406/sheet5EEB6AA2/4: D4A5.1, D4A6.1, D4A7.1, D4A8.1, D4B5.1, D4B6.1, D4B7.1, D4B8.1, D4C5.1, D4C6.1, D4C7.1, D4C8.1, D4D5.1, D4D6.1, D4D7.1, D4D8.1, D4E5.1, D4E6.1, D4E7.1, D4E8.1, D4F5.1, D4F6.1, D4F7.1, D4F8.1, D4G5.1, D4G6.1, D4G7.1, D4G8.1, D4H5.1, D4H6.1, D4H7.1, D4H8.1; also elsewhere on the board
/Sheet5F08D406/sheet5EEB6AA2/5: D5A5.1, D5A6.1, D5A8.1, D5B5.1, D5B6.1, D5B7.1, D5B8.1, D5C5.1, D5C6.1, D5C7.1, D5C8.1, D5D5.1, D5D6.1, D5D7.1, D5D8.1, D5E5.1, D5E6.1, D5E7.1, D5E8.1, D5F5.1, D5F6.1, D5F7.1, D5F8.1, D5G5.1, D5G6.1, D5G7.1, D5G8.1, D5H5.1, D5H6.1, D5H7.1, D5H8.1; also elsewhere on the board
/Sheet5F08D406/sheet5EEB6AA2/6: D6A5.1, D6A6.1, D6A7.1, D6A8.1, D6B5.1, D6B6.1, D6B7.1, D6B8.1, D6C5.1, D6C6.1, D6C7.1, D6C8.1, D6D5.1, D6D6.1, D6D7.1, D6D8.1, D6E5.1, D6E6.1, D6E7.1, D6E8.1, D6F5.1, D6F6.1, D6F7.1, D6F8.1, D6G5.1, D6G6.1, D6G7.1, D6G8.1, D6H5.1, D6H6.1, D6H7.1, D6H8.1; also elsewhere on the board
/Sheet5F08D406/sheet5EEB6AA2/7: D7A5.1, D7A6.1, D7A7.1, D7A8.1, D7B5.1, D7B6.1, D7B7.1, D7B8.1, D7C5.1, D7C6.1, D7C7.1, D7C8.1, D7D5.1, D7D6.1, D7D7.1, D7D8.1, D7E5.1, D7E6.1, D7E7.1, D7E8.1, D7F5.1, D7F6.1, D7F7.1, D7F8.1, D7G5.1, D7G6.1, D7G7.1, D7G8.1, D7H5.1, D7H6.1, D7H7.1, D7H8.1; also elsewhere on the board
