ashleyjr/fft8051/hardware/fft8051/fft8051.kicad_pcb

## KiCad design hardware/fft8051/fft8051.kicad_pcb (continued)

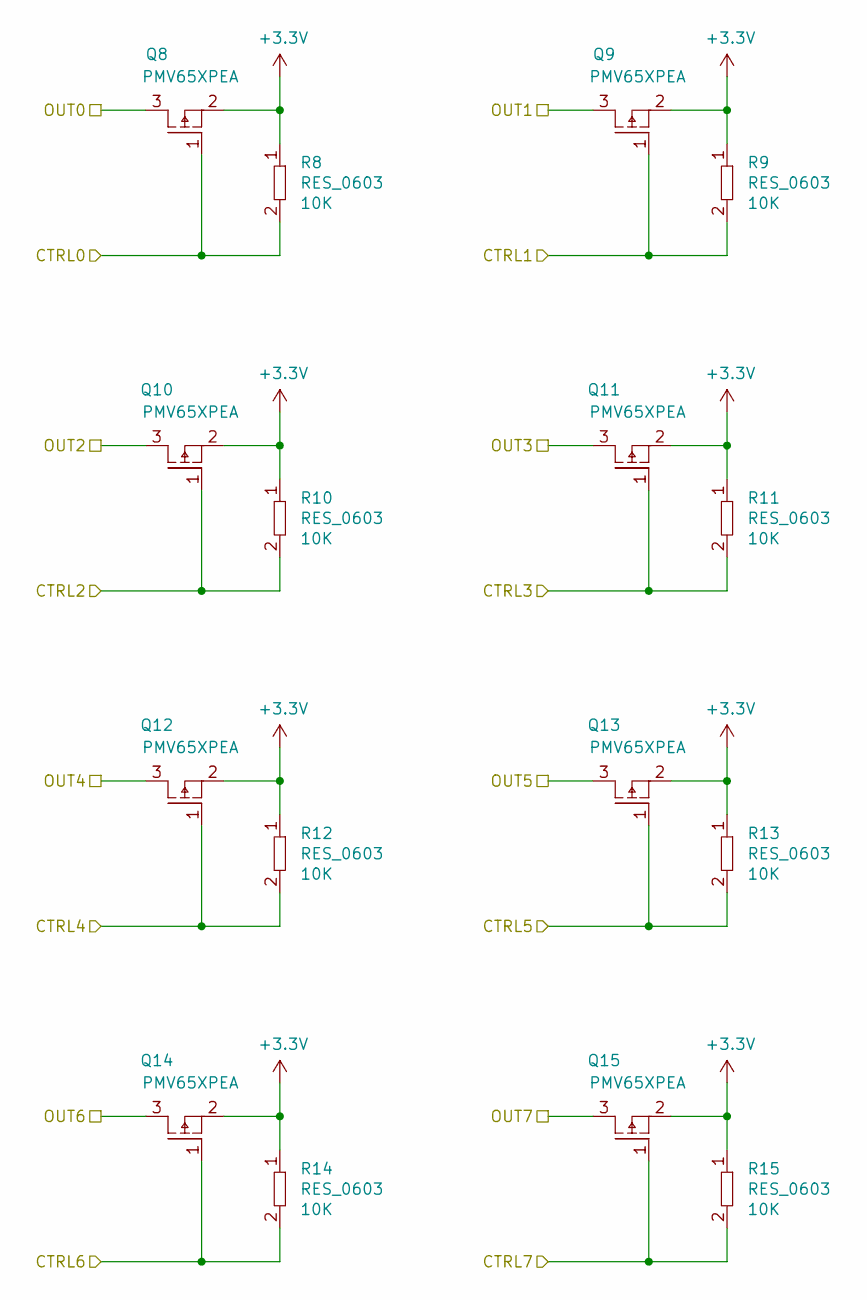
[picture p4: schematic highside_switch_bank.sch]

Parts:
Q0, Q1, Q2, Q3, Q4, Q5, Q6, Q7: PMV65XPEA
R0, R1, R2, R3, R4, R5, R6, R7: RES_0603; 0603

Connections:
+3V3: Q0.2, Q1.2, Q2.2, Q3.2, Q4.2, Q5.2, Q6.2, Q7.2, R0.1, R1.1, R2.1, R3.1, R4.1, R5.1, R6.1, R7.1; also elsewhere on the board
/Sheet5F08D406/Sheet5EE72AD5/0: Q0.3; also elsewhere on the board
/Sheet5F08D406/Sheet5EE72AD5/1: Q1.3; also elsewhere on the board
/Sheet5F08D406/Sheet5EE72AD5/2: Q2.3; also elsewhere on the board
/Sheet5F08D406/Sheet5EE72AD5/3: Q3.3; also elsewhere on the board
/Sheet5F08D406/Sheet5EE72AD5/4: Q4.3; also elsewhere on the board
/Sheet5F08D406/Sheet5EE72AD5/5: Q5.3; also elsewhere on the board
/Sheet5F08D406/Sheet5EE72AD5/6: Q6.3; also elsewhere on the board
/Sheet5F08D406/Sheet5EE72AD5/7: Q7.3; also elsewhere on the board
/Sheet5F08D406/Sheet5F05EF8E/CTRL0: Q0.1, R0.2; also elsewhere on the board
/Sheet5F08D406/Sheet5F05EF8E/CTRL1: Q1.1, R1.2; also elsewhere on the board
/Sheet5F08D406/Sheet5F05EF8E/CTRL2: Q2.1, R2.2; also elsewhere on the board
/Sheet5F08D406/Sheet5F05EF8E/CTRL3: Q3.1, R3.2; also elsewhere on the board
/Sheet5F08D406/Sheet5F05EF8E/CTRL4: Q4.1, R4.2; also elsewhere on the board
/Sheet5F08D406/Sheet5F05EF8E/CTRL5: Q5.1, R5.2; also elsewhere on the board
/Sheet5F08D406/Sheet5F05EF8E/CTRL6: Q6.1, R6.2; also elsewhere on the board
/Sheet5F08D406/Sheet5F05EF8E/CTRL7: Q7.1, R7.2; also elsewhere on the board

Parts of its further copies:
Q8, Q9, Q10, Q11, Q12, Q13, Q14, Q15: PMV65XPEA
R8, R9, R10, R11, R12, R13, R14, R15: RES_0603; 0603

Connections of its further copies:
+3V3: Q8.2, Q9.2, Q10.2, Q11.2, Q12.2, Q13.2, Q14.2, Q15.2, R8.1, R9.1, R10.1, R11.1, R12.1, R13.1, R14.1, R15.1; also elsewhere on the board
/Sheet5F08D406/sheet5EEB6AA2/0: Q8.3; also elsewhere on the board
/Sheet5F08D406/sheet5EEB6AA2/1: Q9.3; also elsewhere on the board
/Sheet5F08D406/sheet5EEB6AA2/2: Q10.3; also elsewhere on the board
/Sheet5F08D406/sheet5EEB6AA2/3: Q11.3; also elsewhere on the board
/Sheet5F08D406/sheet5EEB6AA2/4: Q12.3; also elsewhere on the board
/Sheet5F08D406/sheet5EEB6AA2/5: Q13.3; also elsewhere on the board
/Sheet5F08D406/sheet5EEB6AA2/6: Q14.3; also elsewhere on the board
/Sheet5F08D406/sheet5EEB6AA2/7: Q15.3; also elsewhere on the board
/Sheet5F08D406/sheet5F1B74EF/CTRL0: Q8.1, R8.2; also elsewhere on the board
/Sheet5F08D406/sheet5F1B74EF/CTRL1: Q9.1, R9.2; also elsewhere on the board
/Sheet5F08D406/sheet5F1B74EF/CTRL2: Q10.1, R10.2; also elsewhere on the board
/Sheet5F08D406/sheet5F1B74EF/CTRL3: Q11.1, R11.2; also elsewhere on the board
/Sheet5F08D406/sheet5F1B74EF/CTRL4: Q12.1, R12.2; also elsewhere on the board
/Sheet5F08D406/sheet5F1B74EF/CTRL5: Q13.1, R13.2; also elsewhere on the board
/Sheet5F08D406/sheet5F1B74EF/CTRL6: Q14.1, R14.2; also elsewhere on the board
/Sheet5F08D406/sheet5F1B74EF/CTRL7: Q15.1, R15.2; also elsewhere on the board

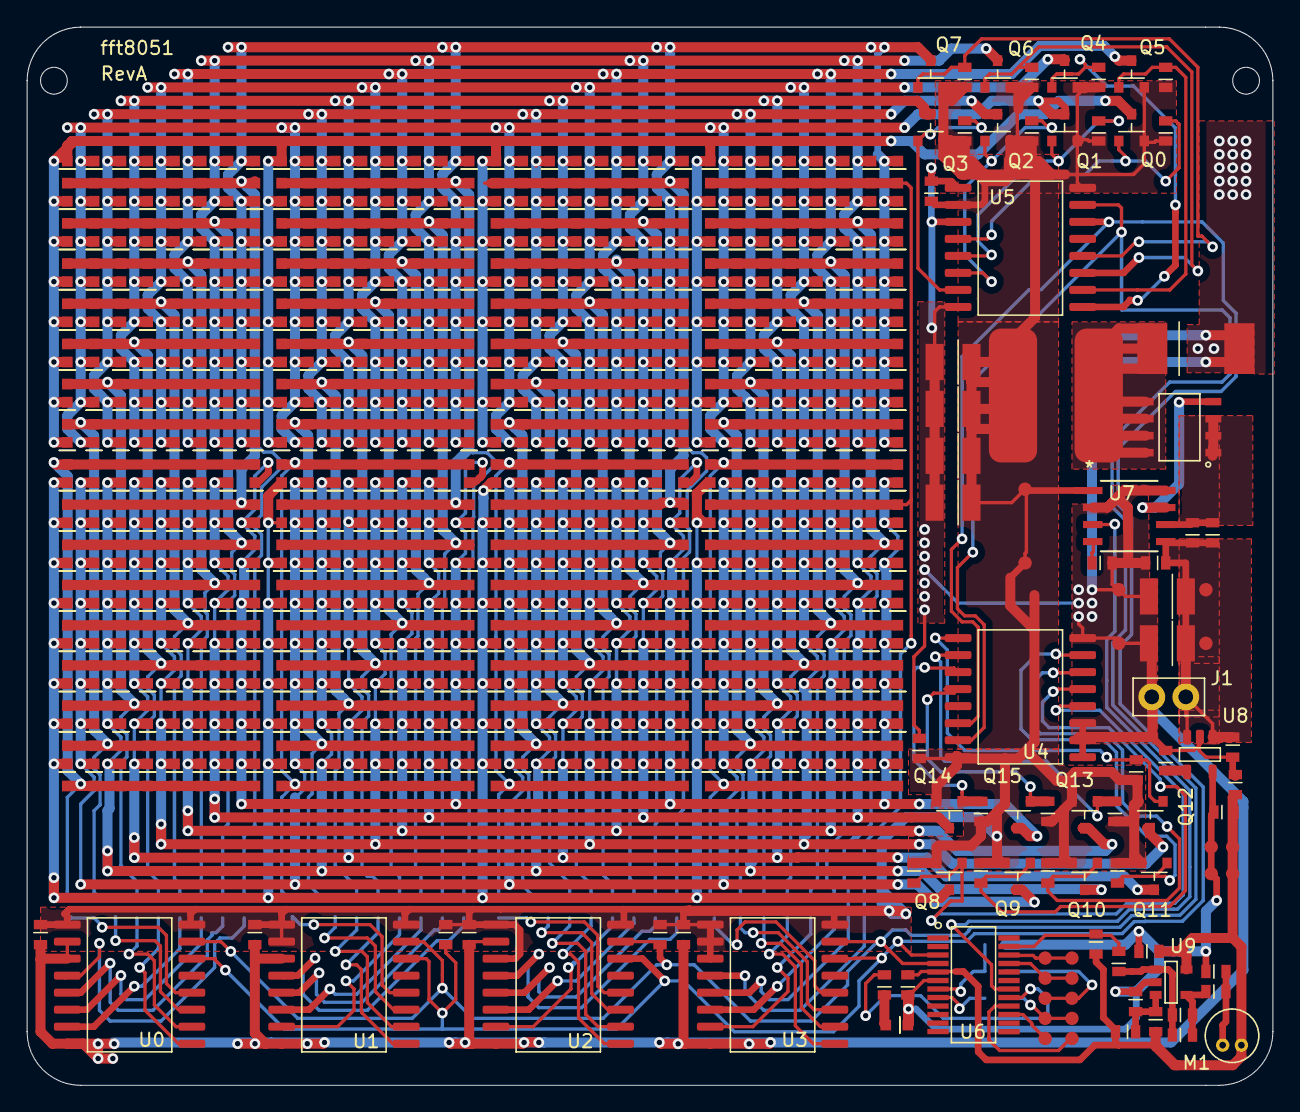
[picture p5: board fft8051.kicad_pcb from above]

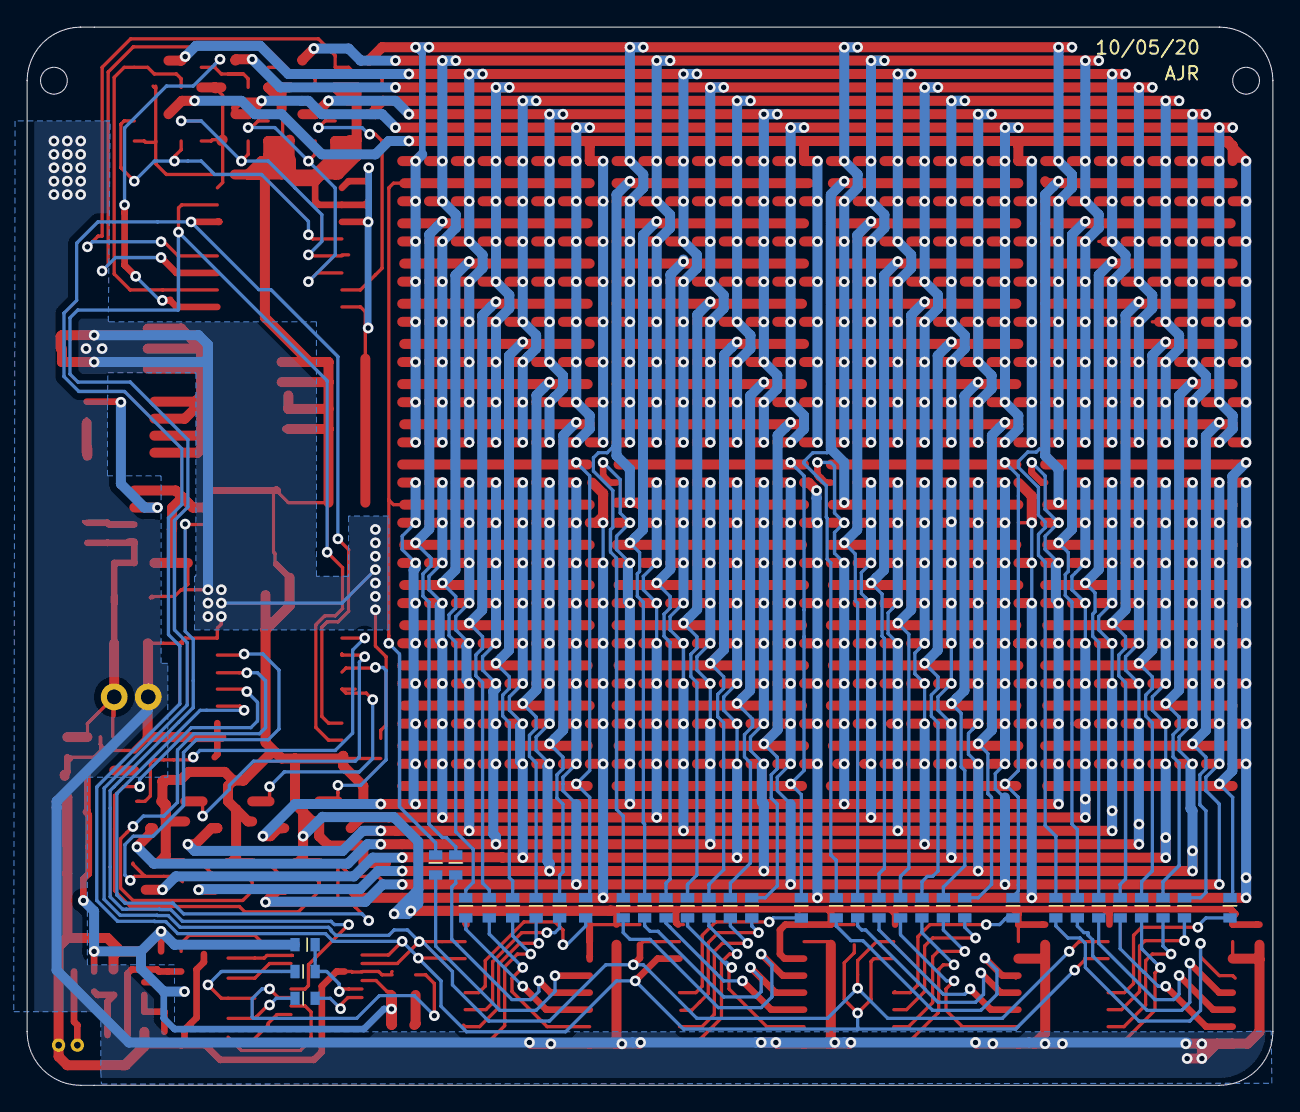
[picture p6: board fft8051.kicad_pcb from below]

Board: 2 copper layers, 93.0 x 79.0 mm, 649 parts (35 on the bottom side), 124 nets.

Other parts of the board:
De: MP001249

Their connections:
/Sheet5F08D406/sheet5EE76798/A: De.2; also elsewhere on the board
/Sheet5F08D406/sheet5EEB6AA2/5: De.1; also elsewhere on the board
