ashleyjr/fft8051/src/main.c

//-----------------------------------------------------------------------------
// Includes
//-----------------------------------------------------------------------------

#include "SI_C8051F850_Register_Enums.h"
#include "SI_C8051F850_Defs.h"
#include "fft8051.h"
#include "disp.h"

//-----------------------------------------------------------------------------
// Defines
//-----------------------------------------------------------------------------

#define DISP_SRC_0   0x70
#define DISP_SRC_1   0x74
#define DISP_SINK_0  0x7E
#define DISP_SINK_1  0x7A
#define DISP_SINK_2  0x76
#define DISP_SINK_3  0x72
#define DISP_X       32
#define DISP_Y       16
#define SMB_MTSTA    0xE0 // (MT) start transmitted
#define SMB_MTDB     0xC0 // (MT) data byte transmitted
#define SMB_MRDB     0x80 // (MR) data byte received

SBIT(SHDN, SFR_P1, 0);  
SBIT(LED,  SFR_P1, 1);  
SBIT(TIME, SFR_P0, 0);  
SBIT(BUT0, SFR_P1, 7);  
SBIT(BUT1, SFR_P2, 1);  

static const U8 sink_lut[4] = {
   DISP_SINK_0,
   DISP_SINK_1,
   DISP_SINK_2,
   DISP_SINK_3,
};

//-----------------------------------------------------------------------------
// Prototypes
//-----------------------------------------------------------------------------

void  setup(void);
void  smbWrite(U8 addr, U8 data);
U8    uartRx(void);
void  uartTx(U8 tx);

//-----------------------------------------------------------------------------
// Global Variables
//-----------------------------------------------------------------------------

volatile static __xdata complex_t s[N]; 
volatile static unsigned char s_ptr;

volatile U8 smb_data_out;                       // Global holder for SMBus data.
volatile U8 smb_target;                             // Target SMBus slave address
volatile U8 smb_busy;                 // Software flag to indicate when the
volatile U8 SMB_RW;                   // Software flag to indicate the

volatile U8 colu;
volatile U8 coll;
volatile U8 state;
volatile U8 image;

volatile U8 chart[N_2];

volatile U32 timer;
//-----------------------------------------------------------------------------
// Main Routine
//-----------------------------------------------------------------------------

void main (void){    
   static unsigned char i,j;
 
   timer = 0;
   s_ptr = 0; 
   SHDN = 1;  
   LED  = 1;
   
   // Driver state machine 
   colu = 0;
   coll = 16;
   state = 0;
   image = 0; 
   setup();
 
   i = 0;

   while(timer < 10000);
   SHDN = 0;
   LED = 0;
   while(timer < 20000);
   LED = 1;
   

   while(1){ 
      // RX a byte then go in to compare mode
      // which tests the FFT algo
      if(SCON0_RI){
         while(1){
            for(i=0;i<N;i++){
               s[i].re = uartRx() - 128;
               s[i].im = 0;
            }
            fft(s); 
            // TX Uart
            for(i=0;i<N;i++){
               uartTx(mag(&s[i])); 
            }
            // Scale to fit on display
            for(i=0;i<N_2;i++){
               chart[i] = mag(&s[N_2-1-i]) >> 2;
            }
            image = 1;
            while(!SCON0_RI);
         } 
      // Run the FFT on ADC readings
      }else{  
         while(s_ptr != N); 
         fft(s); 
         // Scale to fit on display 
         for(i=0;i<N_2;i++){
            uartTx(mag(&s[N_2-1-i]));
            chart[i] = mag(&s[N_2-1-i]) >> 2;
         }
         s_ptr = 0;  
      }
   }
}
 

//-----------------------------------------------------------------------------
// Interrupts
//-----------------------------------------------------------------------------

INTERRUPT (TIMER2_ISR, TIMER2_IRQn){           
   
   LED = 0;
  
   // Global time keeper
   timer++; 
   
   // Take ADC sample
   ADC0CN0 |= ADC0CN0_ADBUSY__SET;
   while(ADC0CN0 & ADC0CN0_ADBUSY__SET);
     
   // ADC Sample
   if(s_ptr < N){ 
      //Places bias at 1V
      s[s_ptr].re = (ADC0 >> 1) - 155;
      s[s_ptr].im = 0;
      s_ptr++;
   } 
   
   LED = 1;
   TMR2CN &= ~TMR2CN_TF2H__SET;
}

INTERRUPT (TIMER3_ISR, TIMER3_IRQn){           
   U8 data; 

   EIE1 &= ~EIE1_ET3__ENABLED;
   
   if(timer > 20000){

                        image = 0;
      if(timer > 40000) image = 1;

      // Select image
      if(6 == state){
         switch(image){
            case 1:   data = (U8)(0x0000FFFF >> (chart[colu]));   break;
            default:  data = (U8)disp_0[colu];                    break;
         }
      }else{
         switch(image){
            case 1:   data = (U8)(0x0000FFFF >> (chart[coll]+8)); break;
            default:  data = (U8)(disp_0[coll] >> 8);             break;
         }
      }
      switch(state){ 
         // Turn everything off
         case 0:  smbWrite(DISP_SRC_0,    0xFF);   break;
         case 1:  smbWrite(DISP_SRC_1,    0xFF);   break;
         case 2:  smbWrite(DISP_SINK_0,   0xFF);   break;
         case 3:  smbWrite(DISP_SINK_1,   0xFF);   break;
         case 4:  smbWrite(DISP_SINK_2,   0xFF);   break;
         case 5:  smbWrite(DISP_SINK_3,   0xFF);   break;       
         // Drive image 
         case 6:  smbWrite(sink_lut[colu >> 3], data);            break; 
         case 7:  smbWrite(DISP_SRC_1, (0xFF7F >> (colu % 8)));   break;
         case 8:  smbWrite(sink_lut[colu >> 3],  0xFF);           break;
         case 9:  smbWrite(DISP_SRC_1,  0xFF);
                  colu++;
                  colu %= DISP_X;
                  break;
         case 10: smbWrite(sink_lut[coll >> 3], data);            break; 
         case 11: smbWrite(DISP_SRC_0, (0xFF7F >> (coll % 8)));   break;
         case 12: smbWrite(sink_lut[coll >> 3],  0xFF);           break;
         case 13: smbWrite(DISP_SRC_0,  0xFF);
                  coll++;
                  coll %= DISP_X;
                  state = 5;
                  break;
      }
      state++;  
   }
   TMR3CN &= ~TMR3CN_TF3H__SET;
   EIE1 |= EIE1_ET3__ENABLED;
}

INTERRUPT(SMBUS0_ISR, SMBUS0_IRQn){ 
   static U8 ADDR_SEND = 0;   // Used by the ISR to flag byte transmissions as slave addresses 
   switch (SMB0CN & 0xF0) {
      // Master Transmitter/Receiver: START condition transmitted.
      case SMB_MTSTA:   SMB0DAT = smb_target;            // Load address of the target slave 
                        SMB0CN_STA = 0;                  // Manually clear START bit
                        ADDR_SEND = 1;
                        break;
      // Master Transmitter: Data byte transmitted only writes
      case SMB_MTDB:    if(SMB0CN_ACK) {
                           if (ADDR_SEND) {              // address,
                              ADDR_SEND = 0;             // Next byte is not a slave address
                              SMB0DAT = smb_data_out;
                           }else{                        // address,
                              SMB0CN_STO = 1;            // Set SMB0CN_STO to terminate transfer
                              smb_busy = 0;              // And free SMBus interface
                           }
                        
                        } else {
                           SMB0CN_STO = 1;               // Send STOP condition,followed
                           SMB0CN_STA = 1;               // By a START 
                        }
                        break;
      default:          break;

   }  
   SMB0CN_SI = 0; //Clear interrupt flag 
}


//-----------------------------------------------------------------------------
// SMB 
//-----------------------------------------------------------------------------

void smbWrite (U8 addr, U8 data){
   while(smb_busy);
   smb_data_out = data;
   smb_target = addr; 
   smb_busy = 1;           // Claim SMBus (set to busy)  
   SMB0CN_STA = 1;         // Start transfer 
}

//-----------------------------------------------------------------------------
// UART
//-----------------------------------------------------------------------------

U8 uartRx(void){
   while(!SCON0_RI);
   SCON0_RI = 0;
   return SBUF0;
}

void uartTx(U8 tx){
   SCON0_TI = 0;
   SBUF0 = tx;
   while(!SCON0_TI); 
}

//-----------------------------------------------------------------------------
// Setup micro
//-----------------------------------------------------------------------------

void setup(void){
   // Disabled watchdog
   WDTCN    = 0xDE;
   WDTCN    = 0xAD;
   // Clock
	CLKSEL   = CLKSEL_CLKSL__HFOSC 	      |     // Use 24.5MHz interal clock
			     CLKSEL_CLKDIV__SYSCLK_DIV_1;      // Do not divide     
   // Setup XBAR       
   P0MDOUT  = P0MDOUT_B4__PUSH_PULL;
   P1SKIP   = P1SKIP_B0__SKIPPED|
              P1SKIP_B1__SKIPPED;
   P1MDOUT  = P1MDOUT_B0__PUSH_PULL|            // LED            
              P1MDOUT_B1__PUSH_PULL;            // LED 
   XBR0     = XBR0_SMB0E__ENABLED| 
              XBR0_URT0E__ENABLED;              // Route out UART P0.4 
   XBR2     = XBR2_WEAKPUD__PULL_UPS_DISABLED | 
              XBR2_XBARE__ENABLED;					  
   // Timer control
	CKCON    = CKCON_T0M__PRESCALE|
              CKCON_SCA__SYSCLK_DIV_12;  
   // SMBus
   SMB0CF   = SMB0CF_INH__SLAVE_DISABLED|
              SMB0CF_SMBCS__TIMER0|
              SMB0CF_SMBFTE__FREE_TO_ENABLED| 
              SMB0CF_ENSMB__ENABLED; 
   // I2C clock on timer 0
   // BAUD gen 115200 on timer 1
	CKCON    |= CKCON_T1M__SYSCLK;
	TMOD     |= TMOD_T0M__MODE2 |
               TMOD_T1M__MODE2;
	TCON     |= TCON_TR0__RUN |
               TCON_TR1__RUN; 
   TH0      = 0xFE;  // I2C SCL - 333KHz (above 100KHz max for drivers datasheet)
   TL0      = 0x00;
   TH1      = 0x96;  // Magic values from datasheet for 115200
	TL1      = 0x96;
   // UART
	SCON0    |= SCON0_REN__RECEIVE_ENABLED; 
   // Timer 2
	TMR2CN   = TMR2CN_TR2__RUN;   // ~10KHz 
   TMR2L    = 0x00;
   TMR2H    = 0xFF;
   TMR2RLL  = 0x00;
   TMR2RLH  = 0xFF;
   // Timer 3
	TMR3CN   = TMR3CN_TR3__RUN;   // ~44 KHz
   TMR3L    = 0x50;
   TMR3H    = 0xFF;
   TMR3RLL  = 0x50;
   TMR3RLH  = 0xFF;
   // ADC
   ADC0MX   = ADC0MX_ADC0MX__ADC0P3;
   ADC0CF   = ADC0CF_ADGN__GAIN_1 |       // ADC gain set to 1
              ADC0CF_ADTM__TRACK_NORMAL;  // Immediate covert
   REF0CN   = REF0CN_REFSL__VDD_PIN;      // Ref to VDD
   ADC0CN0 &= ~ADC0CN0_ADCM__FMASK;
   ADC0CN0 |= ADC0CN0_ADEN__ENABLED |
              ADC0CN0_ADCM__ADBUSY; 
   // Interrupts
	IE   = IE_EA__ENABLED | 
		    IE_ET0__ENABLED|
          IE_ET1__ENABLED|
          IE_ET2__ENABLED;
   EIE1 = EIE1_ESMB0__ENABLED|
          EIE1_ET3__ENABLED;
   IP   = IP_PT2__HIGH;    
}
