ashleyjr/fft8051/(commit log)

2020-03-25 Created printer
2020-04-22 Started I2C driver
2020-05-10 fab output
    [fft8051-B_Cu.gbr, fft8051-B_Mask.gbr, fft8051-B_Paste.gbr, fft8051-B_SilkS.gbr, fft8051-Edge_Cuts.gbr, fft8051-F_Cu.gbr, fft8051-F_Mask.gbr, fft8051-F_Paste.gbr]
2020-11-08 tidy uart rx
2020-11-08 Remove uart functions
2020-11-08 Using global timer
